Shimaomao1/temperature-humidity-alarm-clock/(commit log)

2026-07-19 publish temperature alarm clock project
2026-07-19 update board photo with missing led
2026-07-19 restore original board photo
2026-07-19 refresh restored board photo
2026-07-19 add EasyEDA schematic and PCB project files
    Restore the EasyEDA project packages and README download links.
